Titouan-Beaurepaire/PitBox/pcb/PitBox-PCB.kicad_sch

## KiCad design pcb/PitBox-PCB.kicad_sch (2026-10-30)

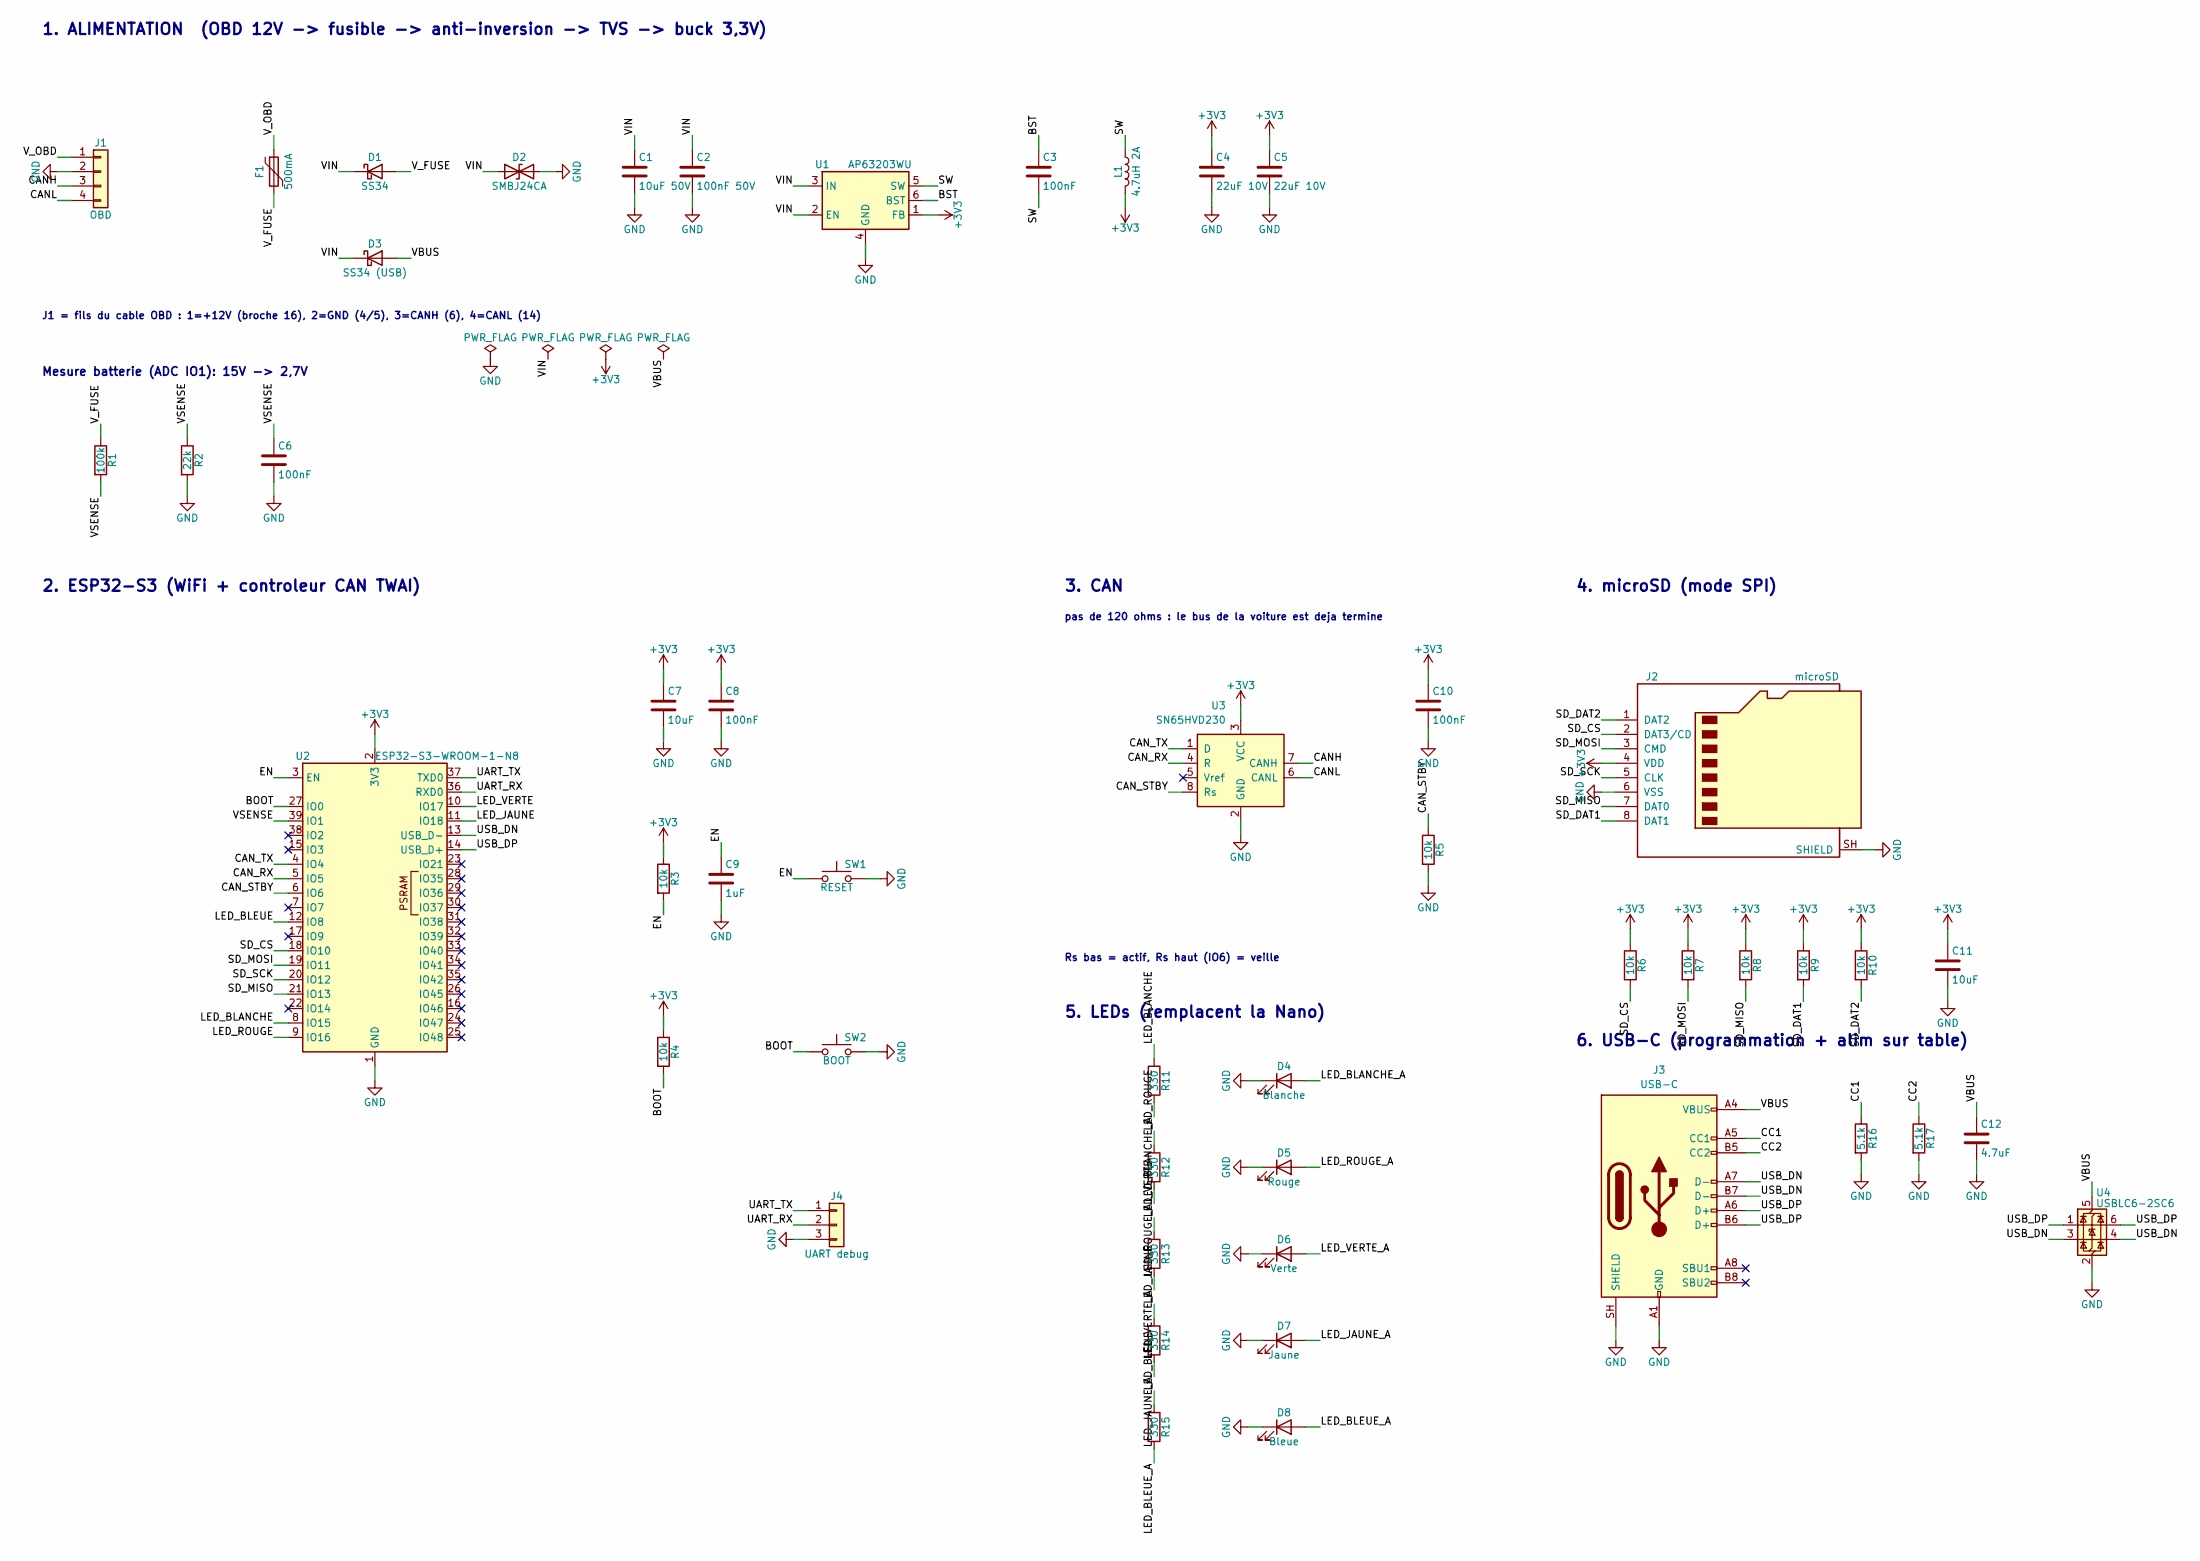
[picture p1: schematic PitBox-PCB.kicad_sch]

Parts:
C1: 10uF 50V; C_1206_3216Metric
C2: 100nF 50V; C_0603_1608Metric
C3, C6, C8, C10: 100nF; C_0603_1608Metric
C4, C5: 22uF 10V; C_0805_2012Metric
C7, C11: 10uF; C_0805_2012Metric
C9: 1uF; C_0603_1608Metric
C12: 4.7uF; C_0805_2012Metric
D1: SS34; D_SMA
D2: SMBJ24CA; D_SMB
D3: SS34 (USB); D_SMA
D4: Blanche; LED_0603_1608Metric
D5: Rouge; LED_0603_1608Metric
D6: Verte; LED_0603_1608Metric
D7: Jaune; LED_0603_1608Metric
D8: Bleue; LED_0603_1608Metric
F1: 500mA; Fuse_1206_3216Metric
J1: OBD; TerminalBlock_Phoenix_MPT-0,5-4-2.54_1x04_P2.54mm_Horizontal
J2: microSD; microSD_HC_Molex_104031-0811
J3: USB-C; USB_C_Receptacle_GCT_USB4105-xx-A_16P_TopMnt_Horizontal
J4: UART debug; PinHeader_1x03_P2.54mm_Vertical
L1: 4.7uH 2A; L_Bourns_SRN6045TA
R1: 100k; R_0603_1608Metric
R2: 22k; R_0603_1608Metric
R3, R4, R5, R6, R7, R8, R9, R10: 10k; R_0603_1608Metric
R11, R12, R13, R14, R15: 330; R_0603_1608Metric
R16, R17: 5.1k; R_0603_1608Metric
SW1: RESET; SW_Push_1P1T_NO_CK_PTS125Sx43PSMTR
SW2: BOOT; SW_Push_1P1T_NO_CK_PTS125Sx43PSMTR
U1: AP63203WU; TSOT-23-6
U2: ESP32-S3-WROOM-1-N8; ESP32-S3-WROOM-1
U3: SN65HVD230; SOIC-8_3.9x4.9mm_P1.27mm
U4: USBLC6-2SC6; SOT-23-6

Connections:
+3V3: C4.1, C5.1, C7.1, C8.1, C10.1, C11.1, J2.4 (VDD), L1.2, R3.1, R4.1, R6.1, R7.1, R8.1, R9.1, R10.1, U1.1 (FB), U2.2 (3V3), U3.3 (VCC)
BOOT: R4.2, SW2.1, U2.27 (IO0)
BST: C3.1, U1.6 (BST)
CANH: J1.3, U3.7 (CANH)
CANL: J1.4, U3.6 (CANL)
CAN_RX: U2.5 (IO5), U3.4 (R)
CAN_STBY: R5.1, U2.6 (IO6), U3.8 (Rs)
CAN_TX: U2.4 (IO4), U3.1 (D)
CC1: J3.A5 (CC1), R16.1
CC2: J3.B5 (CC2), R17.1
EN: C9.1, R3.2, SW1.1, U2.3 (EN)
GND: C1.2, C2.2, C4.2, C5.2, C6.2, C7.2, C8.2, C9.2, C10.2, C11.2, C12.2, D2.2 (A2), D4.1 (K), D5.1 (K), D6.1 (K), D7.1 (K), D8.1 (K), J1.2, J2.6 (VSS), J2.SH (SHIELD), J3.A1 (GND), J3.A12 (GND), J3.B1 (GND), J3.B12 (GND), J3.SH (SHIELD), J4.3, R2.2, R5.2, R16.2, R17.2, SW1.2, SW2.2, U1.4 (GND), U2.1 (GND), U2.40 (GND), U2.41 (GND), U3.2 (GND), U4.2 (GND)
LED_BLANCHE: R11.1, U2.8 (IO15)
LED_BLANCHE_A: D4.2 (A), R11.2
LED_BLEUE: R15.1, U2.12 (IO8)
LED_BLEUE_A: D8.2 (A), R15.2
LED_JAUNE: R14.1, U2.11 (IO18)
LED_JAUNE_A: D7.2 (A), R14.2
LED_ROUGE: R12.1, U2.9 (IO16)
LED_ROUGE_A: D5.2 (A), R12.2
LED_VERTE: R13.1, U2.10 (IO17)
LED_VERTE_A: D6.2 (A), R13.2
SD_CS: J2.2 (DAT3/CD), R6.2, U2.18 (IO10)
SD_DAT1: J2.8 (DAT1), R9.2
SD_DAT2: J2.1 (DAT2), R10.2
SD_MISO: J2.7 (DAT0), R8.2, U2.21 (IO13)
SD_MOSI: J2.3 (CMD), R7.2, U2.19 (IO11)
SD_SCK: J2.5 (CLK), U2.20 (IO12)
SW: C3.2, L1.1, U1.5 (SW)
UART_RX: J4.2, U2.36 (RXD0)
UART_TX: J4.1, U2.37 (TXD0)
USB_DN: J3.A7 (D-), J3.B7 (D-), U2.13 (USB_D-), U4.3 (I/O2), U4.4 (I/O2)
USB_DP: J3.A6 (D+), J3.B6 (D+), U2.14 (USB_D+), U4.1 (I/O1), U4.6 (I/O1)
VBUS: C12.1, D3.2 (A), J3.A4 (VBUS), J3.A9 (VBUS), J3.B4 (VBUS), J3.B9 (VBUS), U4.5 (VBUS)
VIN: C1.1, C2.1, D1.1 (K), D2.1 (A1), D3.1 (K), U1.2 (EN), U1.3 (IN)
VSENSE: C6.1, R1.2, R2.1, U2.39 (IO1)
V_FUSE: D1.2 (A), F1.2, R1.1
V_OBD: F1.1, J1.1

Notes on the sheet:
1. ALIMENTATION (OBD 12V -> fusible -> anti-inversion -> TVS -> buck 3,3V)
Mesure batterie (ADC IO1): 15V -> 2,7V
6. USB-C (programmation + alim sur table)
3. CAN
pas de 120 ohms : le bus de la voiture est deja termine
Rs bas = actif, Rs haut (IO6) = veille
J1 = fils du cable OBD : 1=+12V (broche 16), 2=GND (4/5), 3=CANH (6), 4=CANL (14)
4. microSD (mode SPI)
2. ESP32-S3 (WiFi + controleur CAN TWAI)
5. LEDs (remplacent la Nano)
