Titouan-Beaurepaire/PitBox/firmware/r4_can/arduino_secrets.example.h

// Copier ce fichier en arduino_secrets.h et le remplir : il n'est jamais publié
#define SECRET_SSID  "nom-du-wifi"
#define SECRET_PASS  "mot-de-passe-du-wifi"
#define SECRET_JETON "jeton-du-serveur"
#define SECRET_HOTE  "1-2-3-4.sslip.io"
