Titouan-Beaurepaire/PitBox/(commit log)

2026-10-30 feat(firmware): drive the 5 dashboard LEDs from the Uno
2026-10-30 feat(server): receive, store and broadcast telemetry frames
2026-10-30 feat(pcb): add the ESP32-S3 board schematic
    [PitBox-PCB.kicad_sch]
2026-10-30 feat(firmware): stream frames to the server over WiFi
2026-10-30 docs: add the technical README with wiring diagrams
